GuilhermeLobo225/SA/vision/vision-scheme.png

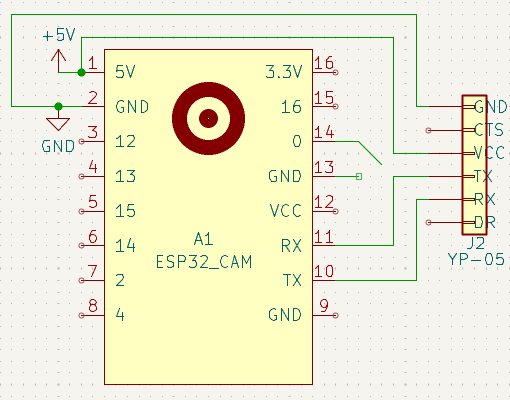
vision/vision-scheme.png
