GuilhermeLobo225/SA/vision/kicad/kicad.kicad_sch

## KiCad design vision/kicad/kicad.kicad_sch (2026-05-16)

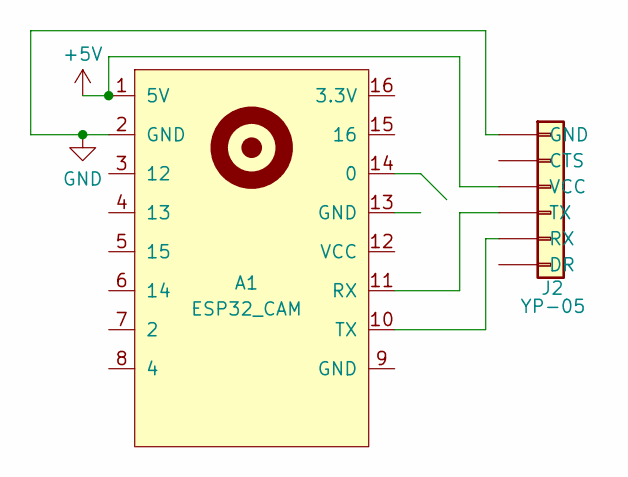
[picture p9: schematic kicad.kicad_sch]

Parts:
A1: ESP32_CAM; ESP32-CAM
J2: YP-05

Connections:
+5V: A1.1 (5V), J2.3 (VCC)
GND: A1.2 (GND), J2.1 (GND)
unnamed: A1.10 (TX), J2.5 (RX)
unnamed: A1.11 (RX), J2.4 (TX)
