GuilhermeLobo225/SA/(notices)

Notices in the files:
app/README.md:
License: Academic
